VIP-LES/leos-radio-pcb/LEOS-radio.kicad_pcb

## KiCad design LEOS-radio.kicad_pcb (2026-10-05)

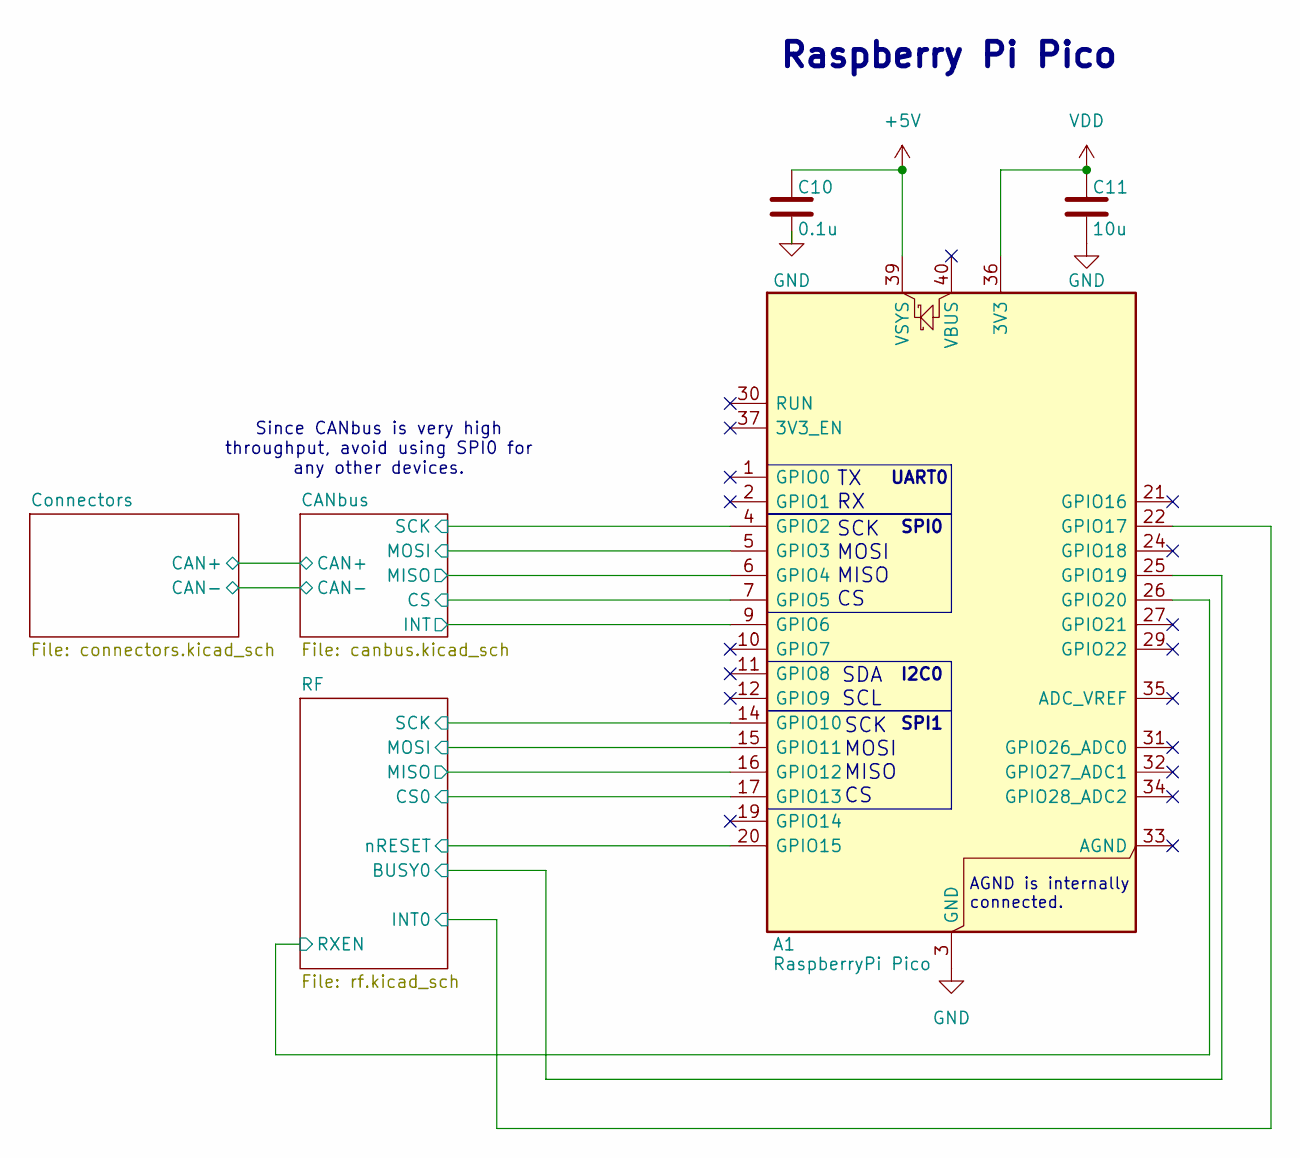
[picture p1: schematic LEOS-radio.kicad_sch, LEOS Radio]

Parts:
A1: RaspberryPi Pico; RaspberryPi_Pico_Common_THT; MPN PIM724; Digikey 1778-PIM724-ND
C10: 0.1u; C_0603_1608Metric; MPN CL10B104KB8NNNL; Digikey 1276-CL10B104KB8NNNLCT-ND
C11: 10u; C_0805_2012Metric; MPN CL21B106KOQNNNE; Digikey 1276-2872-1-ND

Connections:
+5V: A1.39 (VSYS), C10.1; also elsewhere on the board
/CANbus/CS: A1.7 (GPIO5); also elsewhere on the board
/CANbus/INT: A1.9 (GPIO6); also elsewhere on the board
/CANbus/MISO: A1.6 (GPIO4); also elsewhere on the board
/CANbus/MOSI: A1.5 (GPIO3); also elsewhere on the board
/CANbus/SCK: A1.4 (GPIO2); also elsewhere on the board
/RF/BUSY0: A1.25 (GPIO19); also elsewhere on the board
/RF/CS0: A1.17 (GPIO13); also elsewhere on the board
/RF/INT0: A1.22 (GPIO17); also elsewhere on the board
/RF/MISO: A1.16 (GPIO12); also elsewhere on the board
/RF/MOSI: A1.15 (GPIO11); also elsewhere on the board
/RF/RXEN: A1.26 (GPIO20); also elsewhere on the board
/RF/SCK: A1.14 (GPIO10); also elsewhere on the board
/RF/nRESET: A1.20 (GPIO15); also elsewhere on the board
GND: A1.3 (GND), A1.8 (GND), A1.13 (GND), A1.18 (GND), A1.23 (GND), A1.28 (GND), A1.38 (GND), C10.2, C11.2; also elsewhere on the board
VDD: A1.36 (3V3), C11.1; also elsewhere on the board

Notes on the sheet:
SPI1
Raspberry Pi Pico
SCK MOSI MISO CS
Since CANbus is very high throughput, avoid using SPI0 for any other devices.
SPI0
SDA SCL
TX RX
UART0
I2C0
AGND is internally connected.

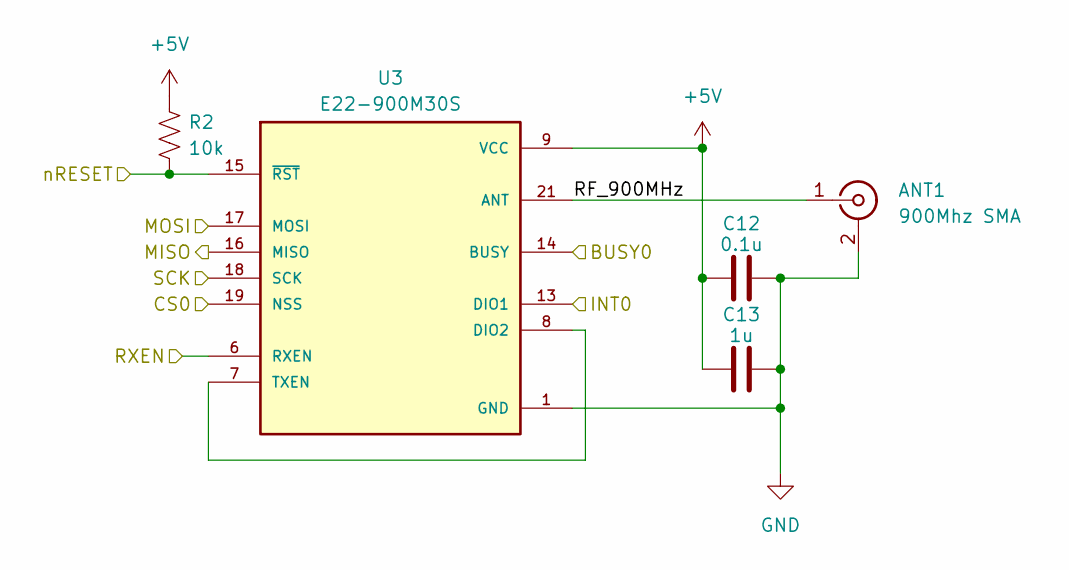
[picture p2: schematic rf.kicad_sch]

Parts:
ANT1: 900Mhz SMA; SMA_Molex_73251-1153_EdgeMount_Horizontal; MPN 0732511153; Digikey 900-0732511153-ND
C12: 0.1u; C_0603_1608Metric; MPN CL10B104KB8NNNL; Digikey 1276-CL10B104KB8NNNLCT-ND
C13: 1u; C_0603_1608Metric; MPN CL10B105KA8NNNC; Digikey 1276-1184-1-ND
R2: 10k; R_0805_2012Metric; MPN CRCW080510K0FKEA; Digikey 541-10.0KCCT-ND
U3: E22-900M30S; XCVR_E22-900M30S; MPN E22-900M30S

Connections:
+5V: C12.1, C13.1, R2.1, U3.9 (VCC), U3.10 (VCC); also elsewhere on the board
/RF/BUSY0: U3.14 (BUSY); also elsewhere on the board
/RF/CS0: U3.19 (NSS); also elsewhere on the board
/RF/INT0: U3.13 (DIO1); also elsewhere on the board
/RF/MISO: U3.16 (MISO); also elsewhere on the board
/RF/MOSI: U3.17 (MOSI); also elsewhere on the board
/RF/RF_900MHz: ANT1.1 (In), U3.21 (ANT)
/RF/RXEN: U3.6 (RXEN); also elsewhere on the board
/RF/SCK: U3.18 (SCK); also elsewhere on the board
/RF/nRESET: R2.2, U3.15 (~RST); also elsewhere on the board
GND: ANT1.2 (Ext), C12.2, C13.2, U3.1 (GND), U3.2 (GND), U3.3 (GND), U3.4 (GND), U3.5 (GND), U3.11 (GND), U3.12 (GND), U3.20 (GND), U3.22 (GND); also elsewhere on the board
unnamed: U3.7 (TXEN), U3.8 (DIO2)

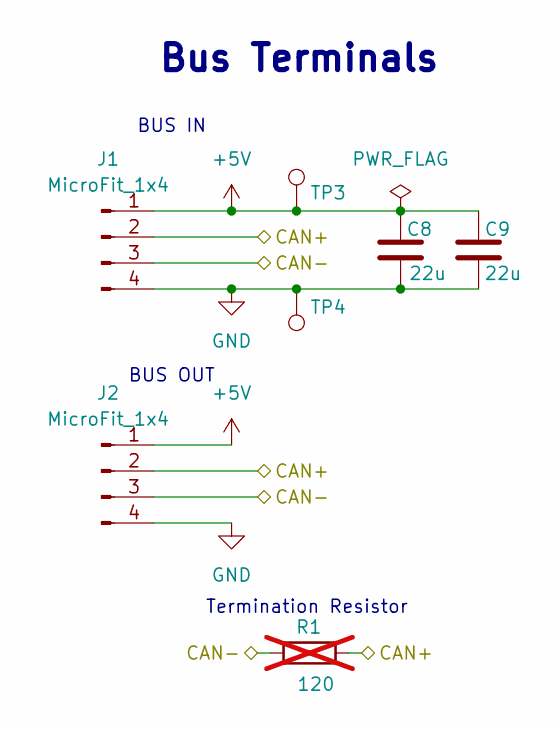
[picture p3: schematic connectors.kicad_sch, LEOS Connectors]

Parts:
C8, C9: 22u; C_0805_2012Metric; MPN CL21A226MAYNNNE; Digikey 1276-CL21A226MAYNNNECT-ND
J1, J2: MicroFit_1x4; Molex_MicroFit3.0_43650-0410_1x04_Horizontal; MPN 0436500409; Digikey WM1882CT-ND
R1: 120; R_Axial_DIN0207_L6.3mm_D2.5mm_P7.62mm_Horizontal; MPN CFR-25JR-52-120R; Digikey 13-CFR-25JR-52-120RCT-ND; not fitted
TP3: 5V Test Point; TestPoint_Loop_D2.60mm_Drill0.9mm_Beaded; MPN 5000; Digikey 36-5000-ND
TP4: GND Test Point; TestPoint_Loop_D2.60mm_Drill0.9mm_Beaded; MPN 5001; Digikey 36-5001-ND

Connections:
+5V: C8.1, C9.1, J1.1, J2.1, TP3.1 (1_1); also elsewhere on the board
/CANbus/CAN+: J1.2, J2.2, R1.2; also elsewhere on the board
/CANbus/CAN-: J1.3, J2.3, R1.1; also elsewhere on the board
GND: C8.2, C9.2, J1.4, J2.4, TP4.1 (1_1); also elsewhere on the board

Notes on the sheet:
BUS OUT
Bus Terminals
BUS IN
Termination Resistor

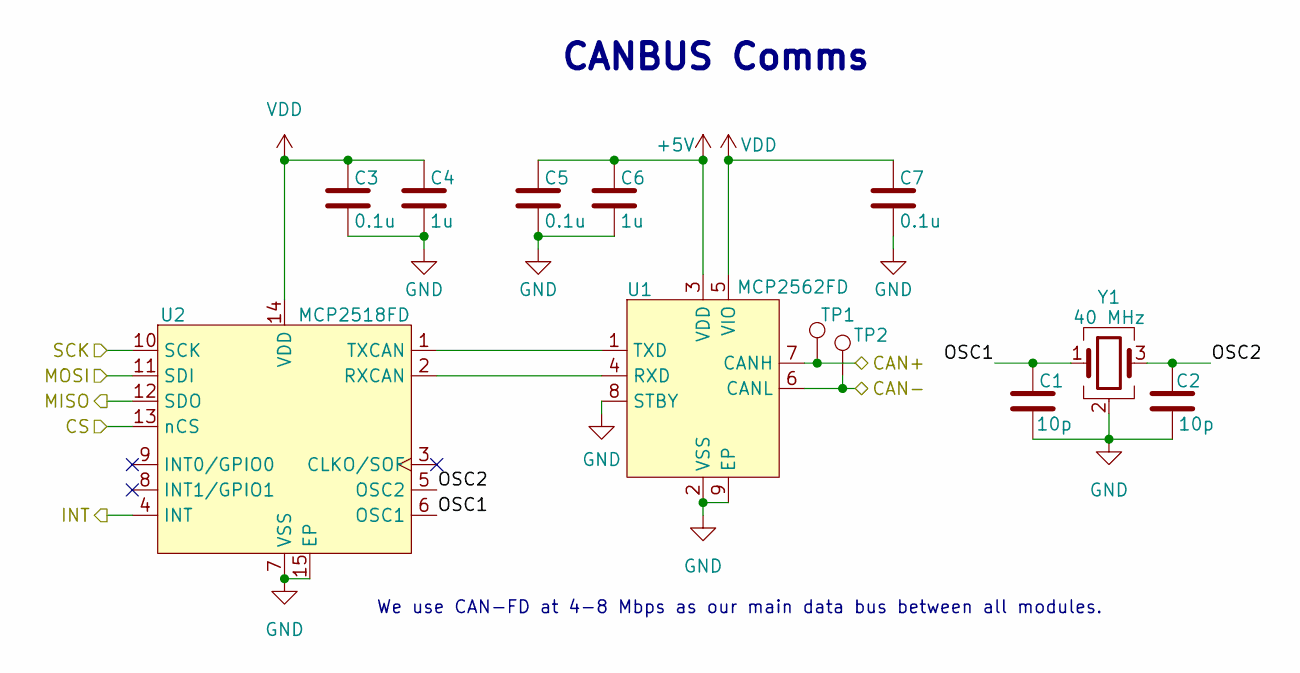
[picture p4: schematic canbus.kicad_sch, LEOS CANbus]

Parts:
C1, C2: 10p; C_0603_1608Metric; MPN CL10C100JB8NNNC; Digikey 1276-1027-1-ND
C3, C5, C7: 0.1u; C_0603_1608Metric; MPN CL10B104KB8NNNL; Digikey 1276-CL10B104KB8NNNLCT-ND
C4, C6: 1u; C_0603_1608Metric; MPN CL10B105KA8NNNC; Digikey 1276-1184-1-ND
TP1: CAN-H Test Point; TestPoint_Loop_D2.60mm_Drill0.9mm_Beaded; MPN 5004; Digikey 36-5004-ND
TP2: CAN-L Test Point; TestPoint_Loop_D2.60mm_Drill0.9mm_Beaded; MPN 5116; Digikey 36-5116-ND
U1: MCP2562FD; SOIC-8_3.9x4.9mm_P1.27mm; MPN MCP2562FDT-E/SN; LCSC C511335
U2: MCP2518FD; SOIC-14_3.9x8.7mm_P1.27mm; MPN MCP2518FDT-E/SL; LCSC C626758
Y1: 40 MHz; Crystal_SMD_2016-4Pin_2.0x1.6mm; MPN ECS-400-10-37B2-CKY-TR; Digikey 50-ECS-400-10-37B2-CKY-TRCT-ND

Connections:
+5V: C5.1, C6.1, U1.3 (VDD); also elsewhere on the board
/CANbus/CAN+: TP1.1 (1_1), U1.7 (CANH); also elsewhere on the board
/CANbus/CAN-: TP2.1 (1_1), U1.6 (CANL); also elsewhere on the board
/CANbus/CS: U2.13 (nCS); also elsewhere on the board
/CANbus/INT: U2.4 (INT); also elsewhere on the board
/CANbus/MISO: U2.12 (SDO); also elsewhere on the board
/CANbus/MOSI: U2.11 (SDI); also elsewhere on the board
/CANbus/OSC1: C1.2, U2.6 (OSC1), Y1.1
/CANbus/OSC2: C2.2, U2.5 (OSC2), Y1.3
/CANbus/SCK: U2.10 (SCK); also elsewhere on the board
GND: C1.1, C2.1, C3.2, C4.2, C5.2, C6.2, C7.2, U1.2 (VSS), U1.8 (STBY), U1.9 (EP), U2.7 (VSS), U2.15 (EP), Y1.2 (G), Y1.4 (G); also elsewhere on the board
unnamed: U1.4 (RXD), U2.2 (RXCAN)
unnamed: U1.1 (TXD), U2.1 (TXCAN)
VDD: C3.1, C4.1, C7.1, U1.5 (VIO), U2.14 (VDD); also elsewhere on the board

Notes on the sheet:
CANBUS Comms
We use CAN-FD at 4-8 Mbps as our main data bus between all modules.

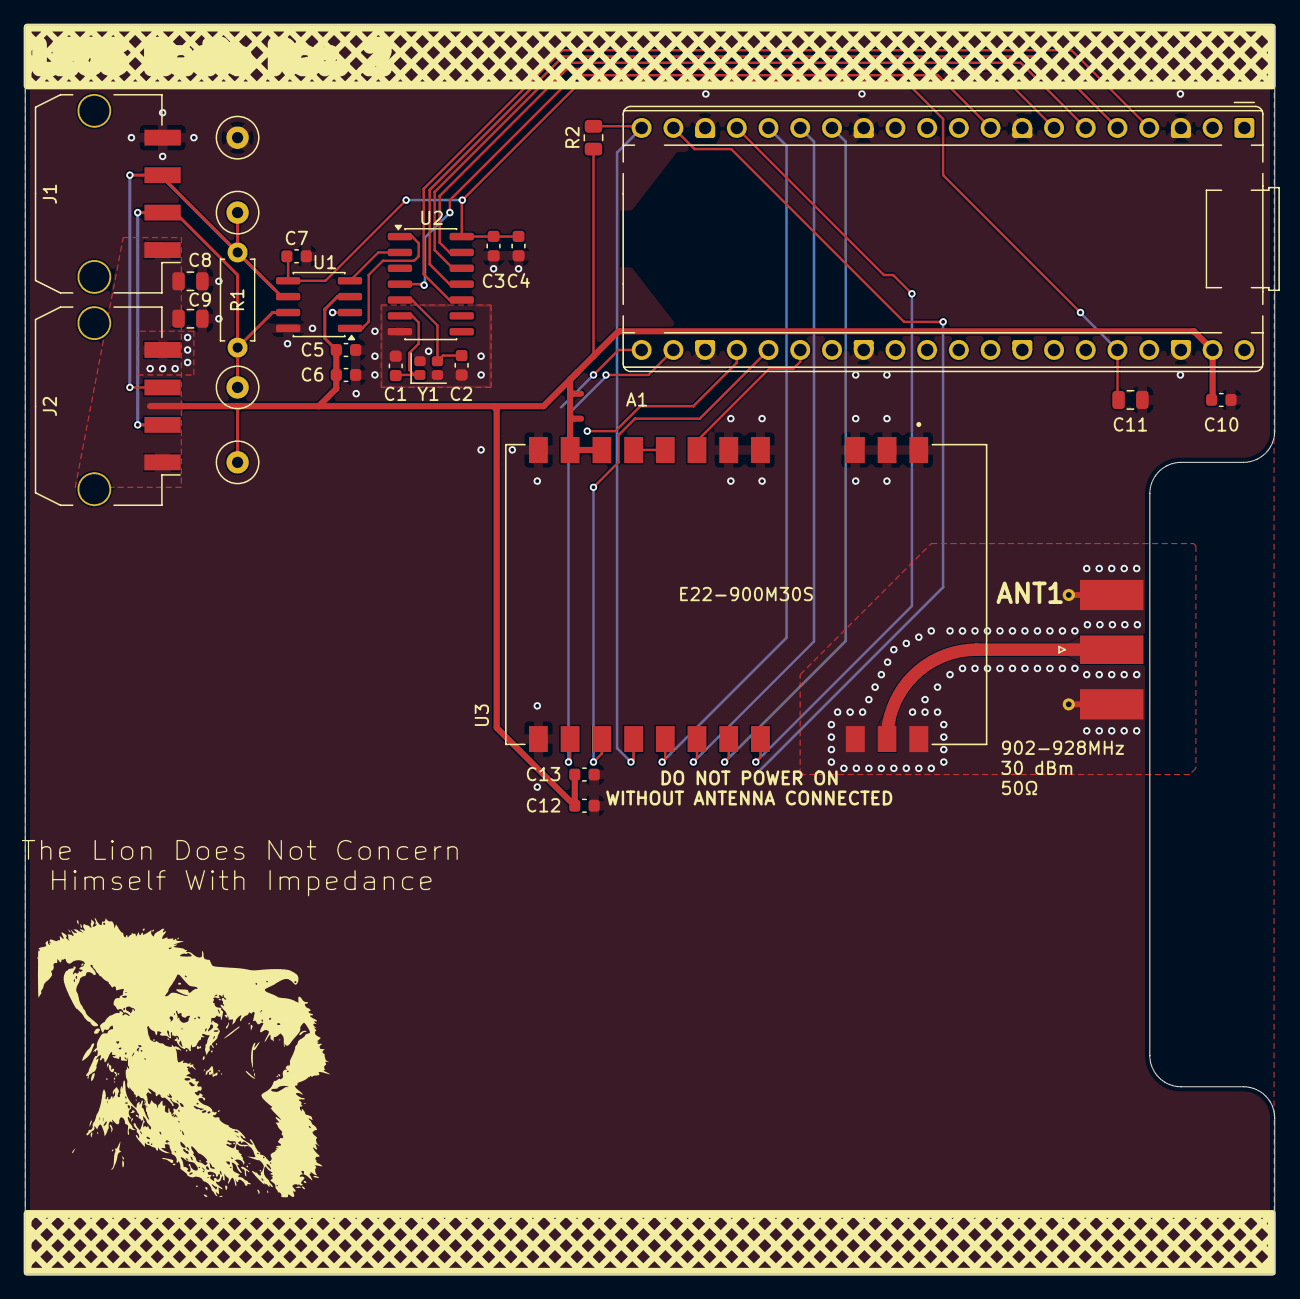
[picture p5: board LEOS-radio.kicad_pcb from above]

Board: 2 copper layers, 100.1 x 100.0 mm, 27 parts (0 on the bottom side), 24 nets.
