VIP-LES/leos-radio-pcb/(commit log)

2026-02-17 Add .gitignore for KiCad and backup files
2026-02-18 update file names
    [LEOS-radio.kicad_pcb, LEOS-radio.kicad_sch]
2026-02-18 v2 with dual 1W LoRa transcievers, edge-mount SMA connectors, and an all new design
    [LEOS-radio.kicad_pcb, LEOS-radio.kicad_sch, LEOS-stack-template.kicad_pcb, LEOS-stack-template.kicad_sch, canbus.kicad_sch, connectors.kicad_sch, rf.kicad_sch]
2026-02-18 Fix backwards ANT labels and increase font size
    [LEOS-radio.kicad_pcb]
2026-10-01 Updated schematic and pcb for rf
    [LEOS-radio.kicad_pcb, LEOS-radio.kicad_sch, rf.kicad_sch]
2026-10-05 updates from radio removal
    [LEOS-radio.csv, LEOS-radio.kicad_pcb, LEOS-radio.kicad_sch, canbus.kicad_sch, connectors.kicad_sch]
